TeraHz/I2C-LED-Driver/Parts.List.ods

Part | Description | Mouser Part # | Future Electronics
R1 | Current Sense Resistors - 1watt 0.22Ω 1% 2512 | 71-WSL2512R2200FEA
R2 | 1/10watt 49.9KΩ 1% 0603 | 71-CRCW0603-49.9K-E3 | CRCW060349K9FKEA
R3 | 1/10watt 6.98KΩ 1% 0603 | 71-CRCW0603-6.98K-E3 | RC0603FR-076K98L
R4 | 1/10watt 1.0KΩ 1% 0603 | 71-CRCW0603-1.0K-E3 | CRCW06031K00FKEA
R5 | 1/10watt 16.5KΩ 1% 0603 | 71-CRCW0603-16.5K-E3 | CRCW060316K5FKEA
R6 | 1/10watt 91KΩ 1% 0603 | 71-CRCW0603-91-E3 | CRCW060391R0FKEA
R7 | 1/10watt 30KΩ 1% 0603 | 71-CRCW0603-30-E3 | RC0603FR-0730RL
R8 | 1/10watt 100KΩ 1% 0603 | 71-CRCW0603-100K-E3 | CRCW0603100KFKEA
R9 | 1/10watt 50Ω 1% 0603 | 71-CRCW0603-50-E3 | CRCW060349R9FKEA
R10 | 1/10watt 10KΩ 1% 0603 | 71-CRCW0603-10K-E3 | CRCW060310K0FKEA
R11 | 1/10watt 10KΩ 1% 0603 | 71-CRCW0603-10K-E3 | CRCW060310K0FKEA
C1 | 100volts 2.2uF 10% X7R 1210 | 80-C1210C225K1R | GRM32RR71E225KA01L
C2 | 100volts 2.2uF 10% X7R 1210 | 80-C1210C225K1R | GRM32RR71E225KA01L
C3 | 1.0uF 16V 10% 0603 | 810-C1608X7R1C105K | CL32B225KBJNNNE
C4 | 0.1uF 50V 5% X7R 0603 | 80-C0603C104J5RAUTO | GRM188R72A104KA35D
C5 | 470pF 50V C0G 5% 0603 | 810-CGA3E2C0G1H471J | GRM1885C2A471JA01D
C6 | 0.1uF 50V 5% X7R 0603 | 80-C0603C104J5RAUTO | GRM188R72A104KA35D
D1 | Schottky (Diodes & Rectifiers) 3A 100V SMC | 621-B3100-F | B3100-13-F
L1 | Power Inductors 33uH 3.5A 57mΩ 12.5x12.5 | 652-SRR1280-330M
Q1 | MOSFET P-Chan 60V 27 Amp 70mΩ 22nC TO220 | 512-FQP27P06 | FQP27P06
U1 | LM3409HV 10-MSOP | 926-LM3409HVMY/NOPB | LM3409HVMY/NOPB | almost half the price at Future
U2 | Op Amp Single 1.8V 1MHz | 579-MCP6001T-I/OT | MCP6001T-I/OT
U3 | 12bit I2C DAC addr: 110000X | 579-MCP4725A0TECH | MCP4725A0T-E/CH | almost half the price at Future
U3 | 12bit I2C DAC addr: 110001X | 579-MCP4725A1T-E/CH | MCP4725A1T-E/CH | almost half the price at Future
U3 | 12bit I2C DAC addr: 110010X | 579-MCP4725A2T-E/CH | MCP4725A2T-E/CH | almost half the price at Future
U3 | 12bit I2C DAC addr: 110011X | 579-MCP4725A3T-E/CH | MCP4725A3T-E/CH | almost half the price at Future
JP1-F | Molex KK 2.54mm Socket 5 pin | 538-22-01-2056
JP1-M | Molex KK 2.54mm Header 5 pin | 538-22-03-2051
JP3-F | Molex KK 2.54mm Socket 2 pin | 538-22-01-2021
JP3-M | Molex KK 2.54mm Header 2 pin | 538-22-03-2021
JP-CRIMP | Molex Crimp Terminal TIN | 538-08-50-0114
Latest BOM:
http://www.mouser.com:80/ProjectManager/ProjectDetail.aspx?AccessID=0d7c3dba77
