TeraHz/I2C-LED-Driver/(commit log)

2012-02-17 Initial import
    [LM3409HV.brd, LM3409HV.sch]
2012-02-17 v0.6 Added a 12bit i2c DAC on the board that allows for nice 4000+ step analog control. Also changed the PFET to a TO-220 package and added a space for a good sized heatsink.
    [LM3409HV.brd, LM3409HV.sch, Parts.List.ods, Parts.List.xls]
2012-02-26 Fixed Q1 part for v0.6 board
    [Parts.List.ods, Parts.List.xls]
2012-03-05 Added copyright
    [LM3409HV.brd, LM3409HV.sch]
2013-10-09 Update note in schematic
    [LM3409HV.sch]
